Richard42Graham/that-jetson-baseboard/design/bcf8fa6561409b0520621ced3928ab8f2c6b4b46.jpeg

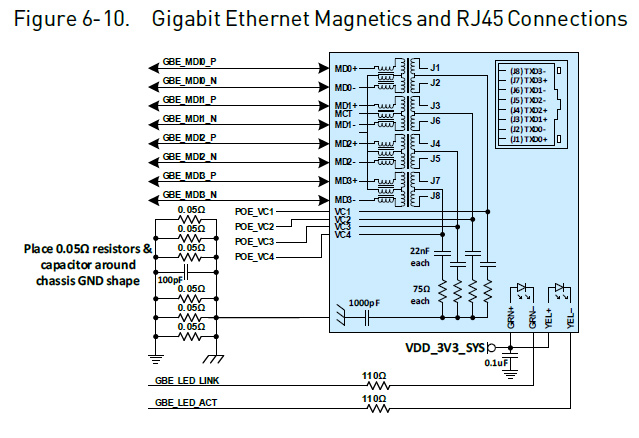
design/bcf8fa6561409b0520621ced3928ab8f2c6b4b46.jpeg
