Richard42Graham/that-jetson-baseboard/design/understanding-the-eight-wires-in-ethernet-cables.jpg

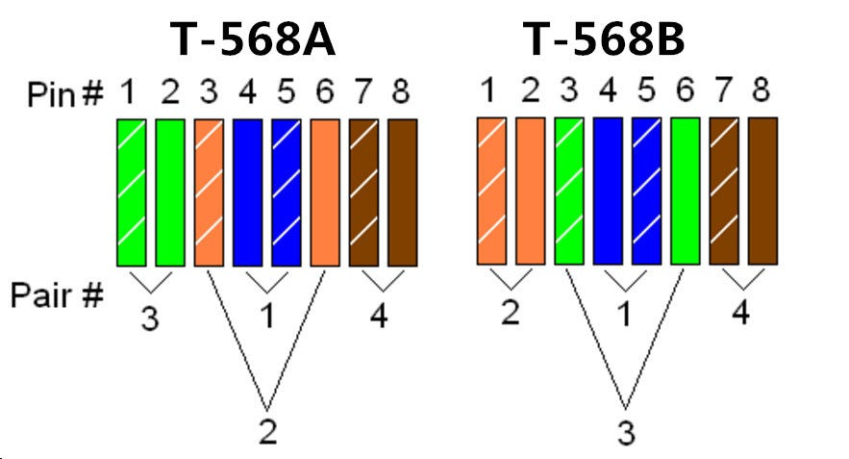
design/understanding-the-eight-wires-in-ethernet-cables.jpg
