Richard42Graham/that-jetson-baseboard/design/baseboard.kicad_pcb

## KiCad design design/baseboard.kicad_pcb (2026-08-18)

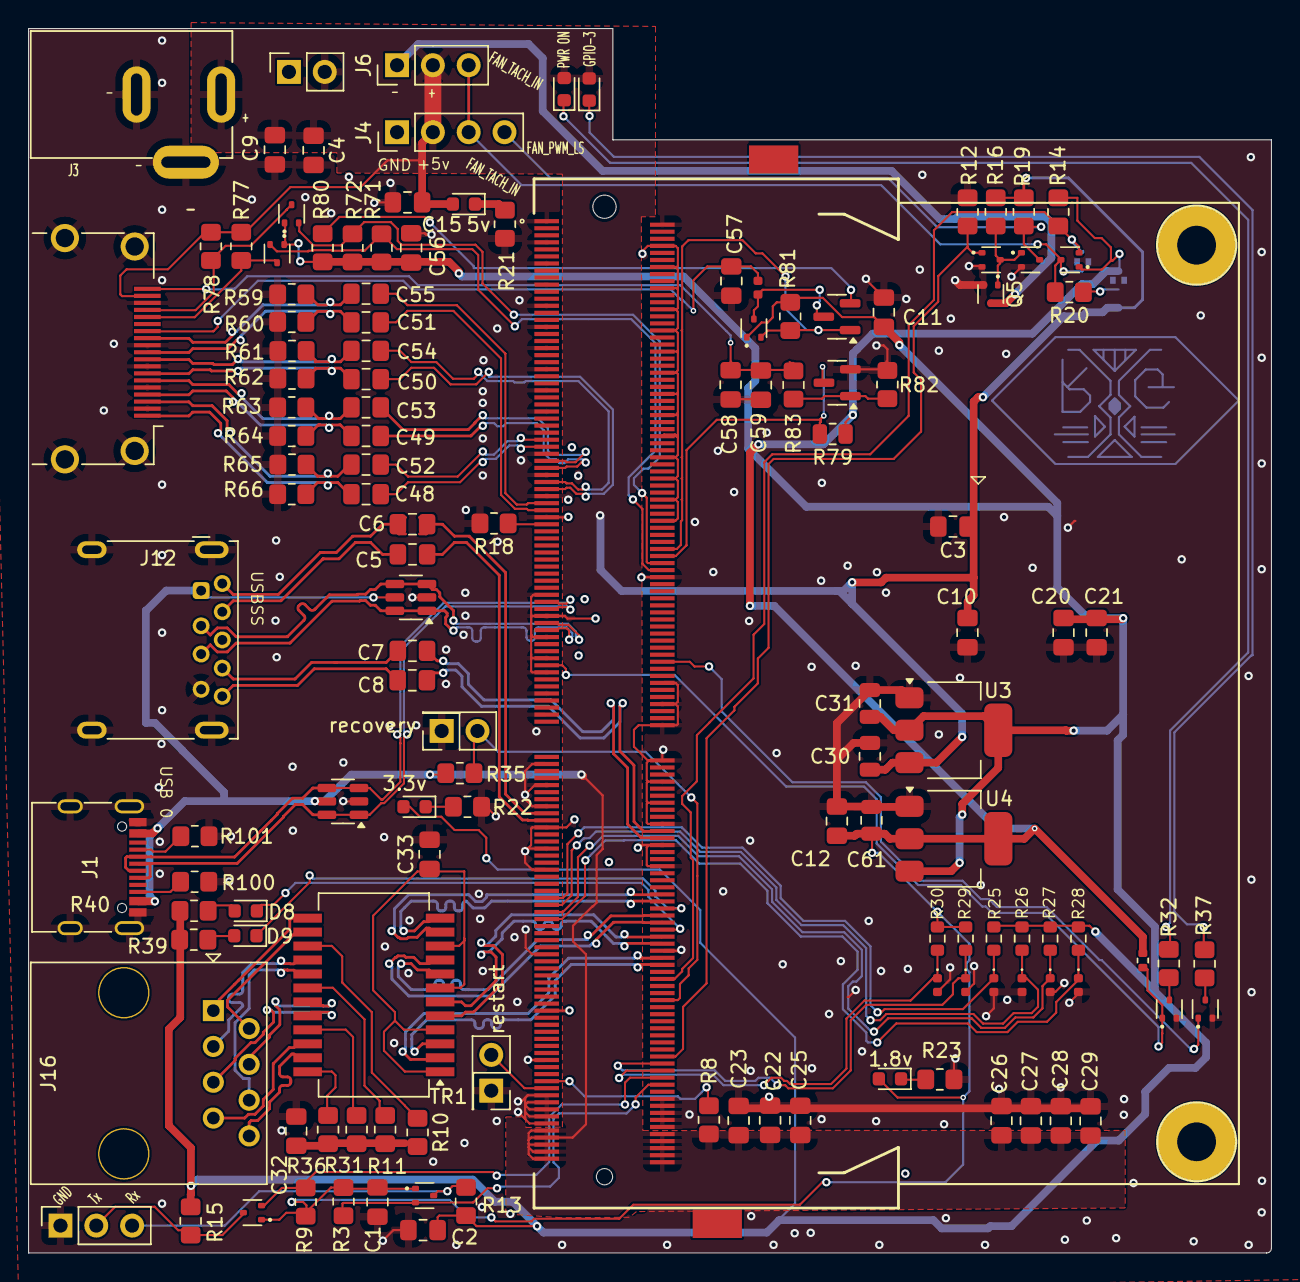
[picture p3: board baseboard.kicad_pcb from above]

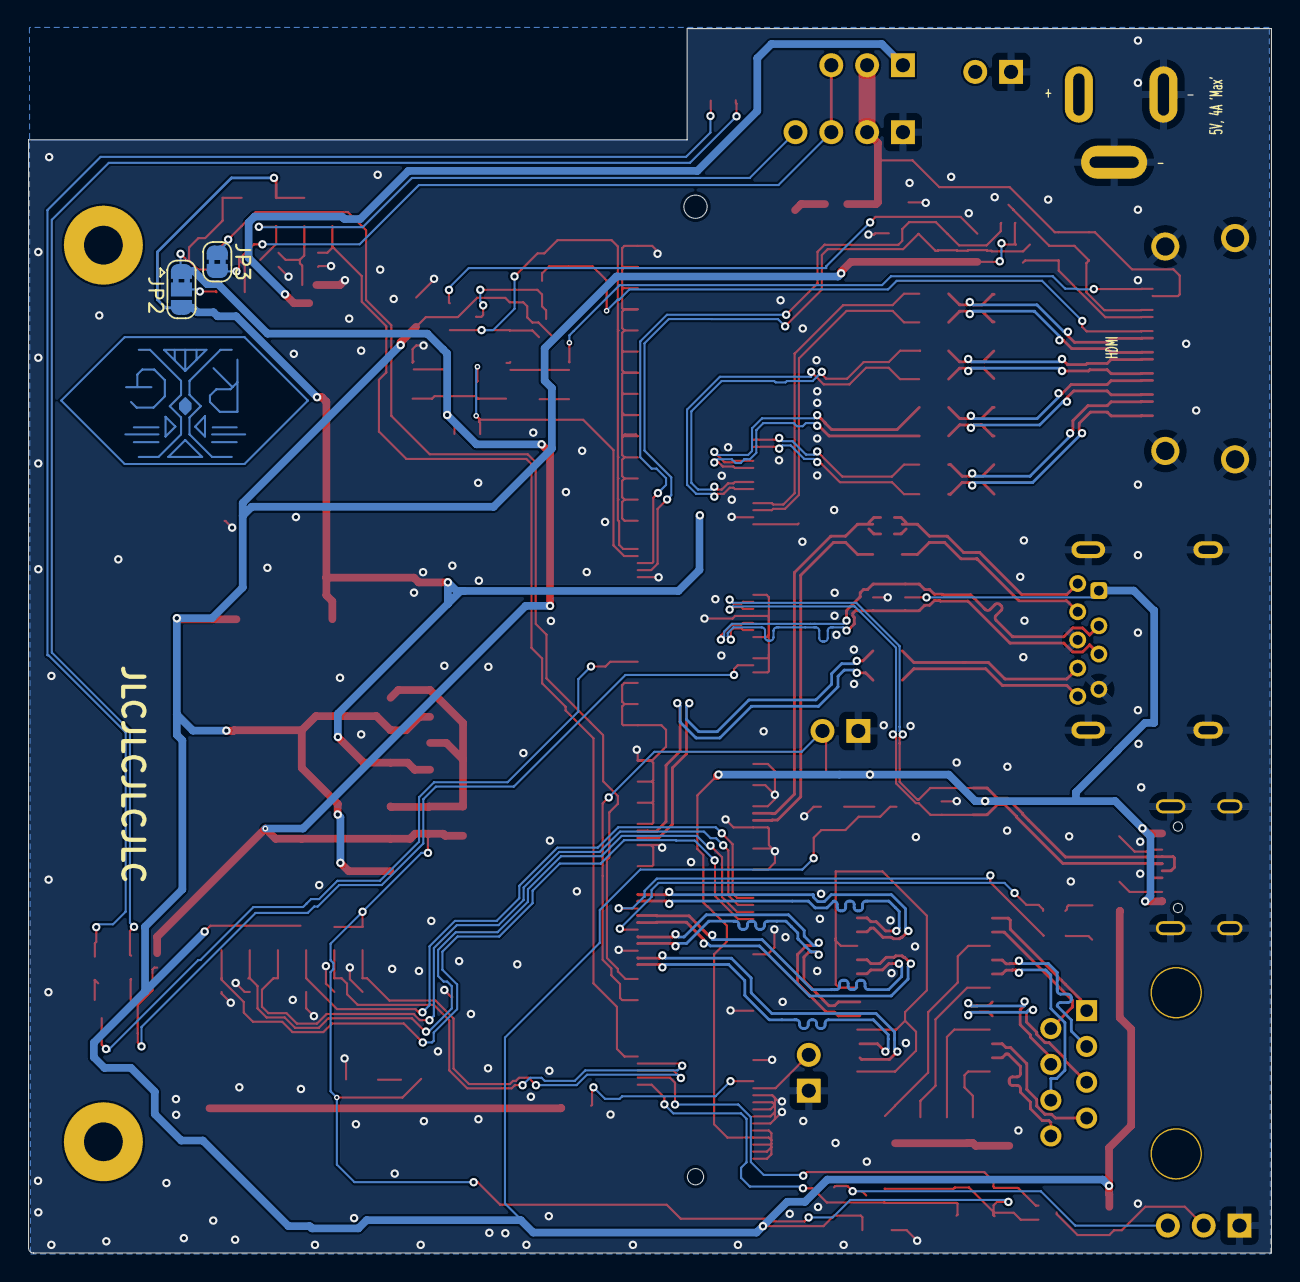
[picture p4: board baseboard.kicad_pcb from below]

Board: 2 copper layers, 88.2 x 86.9 mm, 134 parts (2 on the bottom side), 101 nets.

Parts:
C1, C2, C5, C6, C7, C8, C15, C48, C49, C50, C51, C52, C53, C54, C55, C56, C59: 0.1uF; C_0805_2012Metric_Pad1.18x1.45mm_HandSolder
C3, C4, C9, C22, C23, C25, C26, C27, C28, C29: 100uF; C_0805_2012Metric_Pad1.18x1.45mm_HandSolder
C10, C20: 10uF; C_0805_2012Metric_Pad1.18x1.45mm_HandSolder
C11, C12, C21: 1uF; C_0805_2012Metric_Pad1.18x1.45mm_HandSolder
C30, C31, C61: 10uF; C_0805_2012Metric
C32, C33: 100pF; C_0805_2012Metric_Pad1.18x1.45mm_HandSolder
C57, C58: 15pF; C_0805_2012Metric_Pad1.18x1.45mm_HandSolder
D1: 5v; LED_0603_1608Metric
D2, D20: USBLC6-2SC6; SOT-23-6
D3: 3.3v; LED_0603_1608Metric
D4: BAS70-05; SOT-23
D5: 1.8v; LED_0603_1608Metric
D6, D7: LED; LED_0603_1608Metric
D8: eth0; LED_0603_1608Metric
D9: eth1; LED_0603_1608Metric
D12, D13, D14, D15, D16, D17: TPD1E10B06DPYR; D_0402_1005Metric
J1: USB_C_Receptacle; USB_C_Receptacle_G-Switch_GT-USB-7010ASV
J2: Serial-2; PinSocket_1x03_P2.54mm_Vertical
J3: Jack-DC; NINIGI_DC-005
J4: Conn_01x04_Male; PinHeader_1x04_P2.54mm_Vertical
J5: 2309414-1; SODIMM-DDR4_8mm-NANO
J6: Conn_01x03_Pin; PinHeader_1x03_P2.54mm_Vertical
J8: power in; PinSocket_1x02_P2.54mm_Vertical
J10: restart; PinSocket_2x01_P2.54mm_Vertical
J11: HDMI_A; HDMI_A_Amphenol_10029449-111
J12: USB3_A; USB3_A_Molex_48393-001
J13: recovery; PinSocket_2x01_P2.54mm_Vertical
J16: RJ45; RJ45_OST_PJ012-8P8CX_Vertical
JP2: SolderJumper_3_Bridged12; SolderJumper-3_P1.3mm_Bridged2Bar12_RoundedPad1.0x1.5mm
JP3: SolderJumper_2_Bridged; SolderJumper-2_P1.3mm_Bridged2Bar_RoundedPad1.0x1.5mm
L2: 1.2nH; L_0402_1005Metric
Q1, Q2, Q3, Q4, Q5, Q6, Q7, Q11, Q12, Q13, Q14: DMN26D0UT-7; SOT-523
Q8: MMBT3904; SOT-23
R3, R8, R9, R12, R13, R14, R15, R19, R20, R35, R71, R72, R77, R78, R82, R83: 12k; R_0805_2012Metric_Pad1.20x1.40mm_HandSolder
R10, R11, R31, R36: 75r; R_0805_2012Metric_Pad1.20x1.40mm_HandSolder
R16, R18, R100, R101: 5.1k; R_0805_2012Metric_Pad1.20x1.40mm_HandSolder
R21, R22, R23, R32, R37, R39, R40: 220R; R_0805_2012Metric_Pad1.20x1.40mm_HandSolder
R25, R26, R27, R28, R29, R30: 2.2k; R_0603_1608Metric
R59, R60, R61, R62, R63, R64, R65, R66: 510r; R_0805_2012Metric_Pad1.20x1.40mm_HandSolder
R79: 12k; R_0805_2012Metric
R80: 36k; R_0805_2012Metric_Pad1.20x1.40mm_HandSolder
R81: 120k; R_0805_2012Metric_Pad1.20x1.40mm_HandSolder
R89: 12k; R_0402_1005Metric
TR1: G2415S; Transformer_Ethernet_HALO_TG111-MSC13
U3: AMS1117-3.3; SOT-223-3_TabPin2
U4: AMS1117-1.8; SOT-223-3_TabPin2

Connections:
+1V8: C1.1, C12.1, C61.1, D5.2 (A), JP2.1 (A), Q1.1 (G), Q2.1 (G), Q4.1 (G), R3.1, R9.1, R14.1, R29.1, R30.1, R79.1, R89.1, U4.2 (VO)
+3.3V: C2.1, C11.1, C20.1, C21.1, C31.1, C56.1, D3.2 (A), Q11.1 (G), Q13.1 (G), Q14.1 (G), R13.1, R15.1, R25.1, R26.1, R27.1, R28.1, R39.2, R40.1, R71.1, R72.1, R80.2, R81.1, U3.2 (VO), U4.3 (VI)
+5V: C3.1, C4.1, C9.1, C10.1, C15.1, C22.1, C23.1, C25.1, C26.1, C27.1, C28.1, C29.1, C30.1, D1.2 (A), D2.5 (VBUS), D6.2 (A), D7.2 (A), D20.5 (VBUS), J1.A4 (VBUS), J1.A9 (VBUS), J1.B4 (VBUS), J1.B9 (VBUS), J3.1, J4.2, J5.251 (VDD), J5.252 (VDD), J5.253 (VDD), J5.254 (VDD), J5.255 (VDD), J5.256 (VDD), J5.257 (VDD), J5.258 (VDD), J5.259 (VDD), J5.260 (VDD), J6.2, J8.2, J11.18 (+5V), J12.1 (VBUS), JP2.3 (B), R8.1, R16.1, R19.1, R35.1, R77.2, R78.2, U3.3 (VI)
/HDMI Connections Part 1/HDMI_DDC_SCL_POL_CON: J11.15 (SCL), Q11.3 (D), R77.1
/HDMI Connections Part 1/HDMI_DDC_SDA_POL_CON: J11.16 (SDA), Q13.3 (D), R78.1
/HDMI Connections Part 1/HDMI_TX0_CON_N: C54.1, J11.9 (D0-), R61.1
/HDMI Connections Part 1/HDMI_TX0_CON_P: C50.1, J11.7 (D0+), R62.1
/HDMI Connections Part 1/HDMI_TX1_CON_N: C53.1, J11.6 (D1-), R63.1
/HDMI Connections Part 1/HDMI_TX1_CON_P: C49.1, J11.4 (D1+), R64.1
/HDMI Connections Part 1/HDMI_TX2_CON_N: C52.1, J11.3 (D2-), R65.1
/HDMI Connections Part 1/HDMI_TX2_CON_P: C48.1, J11.1 (D2+), R66.1
/HDMI Connections Part 1/HDMI_TXC_CON_N: C55.1, J11.12 (CK-), R59.1
/HDMI Connections Part 1/HDMI_TXC_CON_P: C51.1, J11.10 (CK+), R60.1
/Power Regulation and Fan Tach/FAN_PWM_INV: Q3.1 (G), Q5.1 (G), Q12.3 (D), R16.2
/Power Regulation and Fan Tach/FAN_PWM_LS: J4.4, Q3.3 (D), R19.2
/Power Regulation and Fan Tach/FAN_TACH_IN: J4.3, J6.3, JP3.2 (B), Q4.3 (D), R20.2
/SODIMM Connections Part 2/VIS_LED_OUT: D7.1 (K), R37.1
/SODIMM Connections Part 2/VIS_SW_D: Q6.3 (D), R37.2
/SODIMM Connections Part 3/FORCE_RECOVERY*: J5.214 (~FORCE_RECOVERY), J13.2, R35.2
/UART to USB Bridge/C1_N: J16.2, TR1.14 (MX4+)
/UART to USB Bridge/C1_P: J16.1, TR1.13 (MX4-)
/UART to USB Bridge/C2_N: J16.6, TR1.17 (MX3+)
/UART to USB Bridge/C2_P: J16.3, TR1.16 (MX3-)
/UART to USB Bridge/C3_N: J16.5, TR1.20 (MX2+)
/UART to USB Bridge/C3_P: J16.4, TR1.19 (MX2-)
/UART to USB Bridge/C4_N: J16.8, TR1.23 (MX1+)
/UART to USB Bridge/C4_P: J16.7, TR1.22 (MX1-)
/USB2.0 Type A Hub/C_USBSS_RX1_N: C8.1, J12.5 (SSRX-)
/USB2.0 Type A Hub/C_USBSS_RX1_P: C7.1, J12.6 (SSRX+)
/USB2.0 Type A Hub/C_USBSS_TX1_N: C5.1, J12.8 (SSTX-)
/USB2.0 Type A Hub/C_USBSS_TX1_P: C6.1, J12.9 (SSTX+)
ENET_LED0: D8.1 (K), J5.194 (GBE_LED_ACT)
ENET_LED1: D9.1 (K), J5.188 (GBE_LED_LINK)
ENET_TRD0_N: J5.184 (GBE_MDI0_N), TR1.11 (TD4+)
ENET_TRD0_P: J5.186 (GBE_MDI0_P), TR1.12 (TD4-)
ENET_TRD1_N: J5.190 (GBE_MDI1_N), TR1.8 (TD3+)
ENET_TRD1_P: J5.192 (GBE_MDI1_P), TR1.9 (TD3-)
ENET_TRD2_N: J5.196 (GBE_MDI2_N), TR1.5 (TD2+)
ENET_TRD2_P: J5.198 (GBE_MDI2_P), TR1.6 (TD2-)
ENET_TRD3_N: J5.202 (GBE_MDI3_N), TR1.2 (TD1+)
ENET_TRD3_P: J5.204 (GBE_MDI3_P), TR1.3 (TD1-)
GND: C1.2, C2.2, C3.2, C4.2, C9.2, C10.2, C11.2, C12.2, C15.2, C20.2, C21.2, C22.2, C23.2, C25.2, C26.2, C27.2, C28.2, C29.2, C30.2, C31.2, C32.2, C33.2, C56.2, C57.2, C58.2, C59.2, C61.2, D2.2 (GND), D12.2 (A2), D13.2 (A2), D14.2 (A2), D15.2 (A2), D16.2 (A2), D17.2 (A2), D20.2 (GND), J1.A1 (GND), J1.A12 (GND), J1.B1 (GND), J1.B12 (GND), J1.S1 (SHIELD), J2.1, J3.2, J3.3, J4.1, J5.1 (GND), J5.2 (GND), J5.7 (GND), J5.8 (GND), J5.13 (GND), J5.14 (GND), J5.19 (GND), J5.20 (GND), J5.25 (GND), J5.26 (GND), J5.31 (GND), J5.32 (GND), J5.37 (GND), J5.38 (GND), J5.43 (GND), J5.44 (GND), J5.49 (GND), J5.50 (GND), J5.55 (GND), J5.56 (GND), J5.61 (GND), J5.62 (GND), J5.67 (GND), J5.68 (GND), J5.73 (GND), J5.74 (GND), J5.79 (GND), J5.80 (GND), J5.85 (GND), J5.86 (GND), J5.102 (GND), J5.107 (GND), J5.113 (GND), J5.119 (GND), J5.125 (GND), J5.129 (GND), J5.132 (GND), J5.135 (GND), J5.138 (GND), J5.141 (GND), J5.144 (GND), J5.146 (GND), J5.147 (GND), J5.152 (GND), J5.153 (GND), J5.158 (GND), J5.159 (GND), J5.164 (GND), J5.165 (GND), J5.170 (GND), J5.171 (GND), J5.176 (GND), J5.177 (GND), J5.200 (GND), J5.201 (GND), J5.217 (GND), J5.231 (GND), J5.241 (GND), J5.242 (GND), J5.243 (GND), J5.244 (GND), J5.245 (GND), J5.246 (GND), J5.247 (GND), J5.248 (GND), J5.249 (GND), J5.250 (GND), J8.1, J10.1, J11.2 (D2S), J11.5 (D1S), J11.8 (D0S), J11.11 (CKS), J11.17 (GND), J11.SH, J12.4 (GND), J12.7 (DRAIN), J12.10 (SHIELD), J13.1, Q3.2 (S), Q5.2 (S), Q6.2 (S), Q7.2 (S), Q8.2 (E), Q12.2 (S), R12.2, R18.2, R21.2, R22.2, R23.2, R59.2, R60.2, R61.2, R62.2, R63.2, R64.2, R65.2, R66.2, R82.2, R100.2, R101.2, U3.1 (GND), U4.1 (GND)
GPIO00: J5.87 (GPIO00_USB_VBUS_EN0), R18.1
GPIO03: J5.126 (GPIO03), Q6.1 (G)
GPIO04: J5.127 (GPIO04), Q7.1 (G), R89.2
GPIO08: J5.208 (GPIO08_SDMMC_CD), JP3.1 (A), Q4.2 (S), R14.2
GPIO14: J5.230 (GPIO14_PWM), Q12.1 (G), R12.1
HDMI_CEC: D4.1 (A1), J5.94 (HDMI_CEC), Q14.2 (S), R81.2
HDMI_CEC_CON: C57.1, J11.13 (CEC), L2.2
HDMI_DDC_SCL_POL: J5.100 (DP1_AUX_P), Q11.2 (S), R71.2
HDMI_DDC_SDA_POL: J5.98 (DP1_AUX_N), Q13.2 (S), R72.2
HDMI_HPD: J5.96 (DP1_HPD), Q8.3 (C), R79.2
HDMI_HPD_CON: C58.1, C59.1, J11.19 (HPD), R83.1
HDMI_TXC_N: C55.2, J5.81 (DP1_TXD3_N)
HDMI_TXC_P: C51.2, J5.83 (DP1_TXD3_P)
HDMI_TXD0_N: C54.2, J5.75 (DP1_TXD2_N)
HDMI_TXD0_P: C50.2, J5.77 (DP1_TXD2_P)
HDMI_TXD1_N: C53.2, J5.69 (DP1_TXD1_N)
HDMI_TXD1_P: C49.2, J5.71 (DP1_TXD1_P)
HDMI_TXD2_N: C52.2, J5.63 (DP1_TXD0_N)
HDMI_TXD2_P: C48.2, J5.65 (DP1_TXD0_P)
I2C0_SCL: D14.1 (A1), J5.185 (I2C0_SCL), R25.2
I2C0_SDA: D12.1 (A1), J5.187 (I2C0_SDA), R26.2
I2C1_SCL: D13.1 (A1), J5.189 (I2C1_SCL), R27.2
I2C1_SDA: D17.1 (A1), J5.191 (I2C1_SDA), R28.2
I2C2_SCL: D15.1 (A1), J5.232 (I2C2_SCL), R29.2
I2C2_SDA: D16.1 (A1), J5.234 (I2C2_SDA), R30.2
unnamed: C32.1, R10.2, R11.2, R31.2, R36.2
unnamed: D1.1 (K), R21.1
unnamed: D3.1 (K), R22.1
unnamed: D4.2 (A2), R80.1
unnamed: D4.3 (C), L2.1, Q14.3 (D)
unnamed: D5.1 (K), R23.1
unnamed: D6.1 (K), R32.1
unnamed: D8.2 (A), R40.2
unnamed: D9.2 (A), R39.1
unnamed: J1.A5 (CC1), R101.1
unnamed: J1.B5 (CC2), R100.1
unnamed: J2.2, Q2.3 (D), R15.2
unnamed: J2.3, Q1.3 (D), R13.2
unnamed: J6.1, Q5.3 (D)
unnamed: JP2.2 (C), R20.1
unnamed: Q7.3 (D), R32.2
unnamed: Q8.1 (B), R82.1, R83.2
unnamed: R36.1, TR1.24 (MCT1)
unnamed: R31.1, TR1.21 (MCT2)
unnamed: R11.1, TR1.18 (MCT3)
unnamed: R10.1, TR1.15 (MCT4)
unnamed: C33.1, TR1.1 (TCT1), TR1.4 (TCT2), TR1.7 (TCT3), TR1.10 (TCT4)
POWER_EN: J5.237 (POWER_EN), R8.2
SYS_RESET*: J5.239 (~SYS_RESET), J10.2
UART2_RXD: J5.238 (UART2_RXD_DEBUG), Q1.2 (S), R3.2
UART2_TXD: J5.236 (UART2_TXD_DEBUG), Q2.2 (S), R9.2
USB0_D_N: D2.3 (I/O2), D2.4 (I/O2), J1.A7 (D-), J1.B7 (D-), J5.109 (USB0_D_N)
USB0_D_P: D2.1 (I/O1), D2.6 (I/O1), J1.A6 (D+), J1.B6 (D+), J5.111 (USB0_D_P)
USB1_D_N: D20.3 (I/O2), D20.4 (I/O2), J5.115 (USB1_D_N), J12.2 (D-)
USB1_D_P: D20.1 (I/O1), D20.6 (I/O1), J5.117 (USB1_D_P), J12.3 (D+)
USBSS_RX6_N: C5.2, J5.163 (USBSS_RX_P)
USBSS_RX6_P: C6.2, J5.161 (USBSS_RX_N)
USBSS_TX6_N: C7.2, J5.168 (USBSS_TX_P)
USBSS_TX6_P: C8.2, J5.166 (USBSS_TX_N)
