Richard42Graham/that-jetson-baseboard/(commit log)

2025-06-11 removed most components, and re did layout
    [Page1.kicad_sch, Page1.sch, Page10.kicad_sch, Page10.sch, Page11.kicad_sch, Page11.sch, Page12.kicad_sch, Page12.sch]
2025-06-11 updaed some compoent footprints and layouts to make it easier for manufacturing
    [jetson-minimal.kicad_pcb, jetson-minimal.kicad_sch]
2025-06-15 produced production files for PCB fabrication.
    [bom.csv]
2025-06-15 updated the actual files.
    [jetson-minimal.kicad_pcb]
2025-07-10 updated 3d modles for jetson holder, and usb c port, and updated the part numbers as well
    [jetson-minimal.kicad_pcb]
2026-07-27 updated, its functional, but needs routing finished. tweeks from Bornhack 2026 to be added. :)
    [Page1.kicad_sch, Page10.kicad_sch, Page12.kicad_sch, Page13.kicad_sch, Page2.kicad_sch, Page3.kicad_sch, Page4.kicad_sch, Page4b.kicad_sch]
2026-07-31 finished routing, doing some cleanup next.
    [baseboard.kicad_pcb, bom.csv, designators.csv, positions.csv]
2026-08-07 cleaned up a bit, more to do
    [Page1.kicad_sch, Page10.kicad_sch, Page3.kicad_sch, Page4b.kicad_sch, Page9.kicad_sch, baseboard.kicad_pcb, baseboard.kicad_sch, old_baseboard.kicad_pcb]
2026-08-12 updated little details.
    [Page1.kicad_sch, Page13.kicad_sch, baseboard.kicad_pcb]
2026-08-18 added a 3 pin fan header PWM controlled of course.
    [Page1.kicad_sch, Page3.kicad_sch, baseboard.kicad_pcb]
